GhassenJamoussi99/Rotation-Wheel-Inverted-Pendulum-RWIP/motor_control_test/README.md

# RWIP Project README

This directory serves as the central repository for tracking the results and progress of the RWIP (Rotation Wheel Inverted Pendulum) project throughout various semesters.

The final result is uploaded on youtube privately (accessible through the link):

Swing-Up Stabilization with Force (http://www.youtube.com/watch?v=k0FuAN_W_Ps)
