GhassenJamoussi99/Rotation-Wheel-Inverted-Pendulum-RWIP/rwip - stm32g4xx/rwip/Inc/drive_parameters.h

#define DRIVE_PARAMETERS_H
#define MAX_APPLICATION_SPEED_RPM       3430
#define MIN_APPLICATION_SPEED_RPM       0
#define M1_SS_MEAS_ERRORS_BEFORE_FAULTS 3
#define ENC_AVERAGING_FIFO_DEPTH        16
#define REV_PARK_ANGLE_COMPENSATION_FACTOR 0
#define PWM_FREQUENCY   30000
#define PWM_FREQ_SCALING 1
#define LOW_SIDE_SIGNALS_ENABLING        ES_GPIO
#define REGULATION_EXECUTION_RATE     1
#define PID_TORQUE_KP_DEFAULT         15500
#define PID_TORQUE_KI_DEFAULT         250
#define PID_TORQUE_KD_DEFAULT         3500
#define PID_FLUX_KP_DEFAULT           520
#define PID_FLUX_KI_DEFAULT           260
#define PID_FLUX_KD_DEFAULT           100
#define TF_KPDIV                      16384
#define TF_KIDIV                      16384
#define TF_KDDIV                      8192
#define TF_KPDIV_LOG                  LOG2((16384))
#define TF_KIDIV_LOG                  LOG2((16384))
#define TF_KDDIV_LOG                  LOG2((8192))
#define TFDIFFERENTIAL_TERM_ENABLING  DISABLE
#define SPEED_LOOP_FREQUENCY_HZ       ( uint16_t )1000
#define PID_SPEED_KP_DEFAULT          5500/(SPEED_UNIT/10)
#define PID_SPEED_KI_DEFAULT          50/(SPEED_UNIT/10)
#define PID_SPEED_KD_DEFAULT          5000/(SPEED_UNIT/10)
#define SP_KPDIV                      64
#define SP_KIDIV                      16384
#define SP_KDDIV                      16
#define SP_KPDIV_LOG                  LOG2((64))
#define SP_KIDIV_LOG                  LOG2((16384))
#define SP_KDDIV_LOG                  LOG2((16))
#define PID_SPEED_INTEGRAL_INIT_DIV 1
#define SPD_DIFFERENTIAL_TERM_ENABLING DISABLE
#define IQMAX                          12016
#define DEFAULT_CONTROL_MODE           MCM_SPEED_MODE
#define DEFAULT_TARGET_SPEED_RPM       1496
#define DEFAULT_TARGET_SPEED_UNIT      (DEFAULT_TARGET_SPEED_RPM*SPEED_UNIT/U_RPM)
#define DEFAULT_TORQUE_COMPONENT       0
#define DEFAULT_FLUX_COMPONENT         0
#define OV_VOLTAGE_THRESHOLD_V          16
#define UD_VOLTAGE_THRESHOLD_V          5
#ifdef NOT_IMPLEMENTED
#define ON_OVER_VOLTAGE                 TURN_OFF_PWM
#endif
#define OV_TEMPERATURE_THRESHOLD_C      110
#define OV_TEMPERATURE_HYSTERESIS_C     10
#define HW_OV_CURRENT_PROT_BYPASS       DISABLE
#define OVP_INVERTINGINPUT_MODE         INT_MODE
#define OVP_INVERTINGINPUT_MODE2        INT_MODE
#define OVP_SELECTION                   COMP_Selection_COMP1
#define OVP_SELECTION2                  COMP_Selection_COMP1
#define ALIGNMENT_DURATION              700
#define ALIGNMENT_ANGLE_DEG             90
#define FINAL_I_ALIGNMENT               12016
#define TRANSITION_DURATION            25
#define  M1_VBUS_SAMPLING_TIME  LL_ADC_SAMPLING_CYCLE(47)
#define  M1_TEMP_SAMPLING_TIME  LL_ADC_SAMPLING_CYCLE(47)
#define ADC_SAMPLING_CYCLES (6 + SAMPLING_CYCLE_CORRECTION)
