GhassenJamoussi99/Rotation-Wheel-Inverted-Pendulum-RWIP/rwip - stm32g4xx/rwip/Final_Motor.ioc

Mcu.UserName=STM32G431RBTx
PA0.GPIO_Label=M1_BUS_VOLTAGE
PA0.Signal=ADC1_IN1
PA1.GPIO_Label=M1_CURR_AMPL_U
PA1.Signal=ADC1_IN2
PA10.GPIO_Label=M1_PWM_WH
PA10.Signal=S_TIM1_CH3
PA13.GPIO_Label=TMS
PA13.Signal=SYS_JTMS-SWDIO
PA14.GPIO_Label=TCK
PA14.Signal=SYS_JTCK-SWCLK
PA2.GPIO_Label=UART_TX
PA2.Signal=USART2_TX
PA3.GPIO_Label=UART_RX
PA3.Signal=USART2_RX
PA7.GPIO_Label=M1_CURR_AMPL_W
PA7.Signal=ADC2_IN4
PA8.GPIO_Label=M1_PWM_UH
PA8.Signal=S_TIM1_CH1
PA9.GPIO_Label=M1_PWM_VH
PA9.Signal=S_TIM1_CH2
PB11.GPIO_Label=M1_CURR_AMPL_V
PB11.Signal=SharedAnalog_PB11
PB12.GPIO_Label=M1_OCP
PB12.Signal=TIM1_BKIN
PB13.GPIO_Label=M1_PWM_EN_U
PB13.Signal=GPIO_Output
PB14.GPIO_Label=M1_PWM_EN_V
PB14.Signal=GPIO_Output
PB15.GPIO_Label=M1_PWM_EN_W
PB15.Signal=GPIO_Output
PB6.Signal=S_TIM4_CH1
PB7.Signal=S_TIM4_CH2
PC13.GPIO_Label=Start/Stop [PushButton]
PC13.Signal=GPXTI13
PC4.GPIO_Label=M1_TEMPERATURE
PC4.Signal=ADC2_IN5
PC6.GPIO_Label=M1_ENCODER_A
PC6.Signal=S_TIM3_CH1
PC7.GPIO_Label=M1_ENCODER_B
PC7.Signal=S_TIM3_CH2
PF0-OSC_IN.Signal=RCC_OSC_IN
PF1-OSC_OUT.Signal=RCC_OSC_OUT
