GhassenJamoussi99/Rotation-Wheel-Inverted-Pendulum-RWIP/(notices)

Notices in the files:
rwip - stm32g4xx/rwip/Inc/main.h:
Copyright (c) 2023 STMicroelectronics.
All rights reserved.
This software is licensed under terms that can be found in the LICENSE file
